NessieCircuits/Riotee_KicadLibrary/README.md

# KiCad Parts library for Riotee Hardware

This repository contains schematic symbols and footprints for the parts on the Riotee board, Riotee probe and the Riotee shields.

Since quite some of the parts are shared betwen the designs, we keep them in this central repository which is integrated as submodule in the other repositories.
