NessieCircuits/Riotee_KicadLibrary/(commit log)

2023-01-14 optimize sensor stencil openings
2023-01-15 add flexypin footprints
2023-02-16 add TS5A3166 and TLV71320 devices
2023-02-24 colored model of TE_1825058-1 dip switch
2023-02-24 color pin headers and 8-position DIP switch
2023-04-10 fix VM1010 footprint
2023-04-10 fix USB connector 3D model placement
2023-04-10 add solder bridge footprint
2023-04-12 update riotee module pin names
2023-04-13 refine assembly drawings of SHTC3 and VM1010
2023-04-13 add marker for negative pin of supercaps
2023-04-14 fix footprint SMD/THT property
2023-04-14 improve KXOB25 assembly drawing
2023-04-28 migrate symbol library to kicad 7
2023-04-28 migrate some footprints to kicad 7
2023-04-28 add sot23 footprint for diodes pmos
2023-04-28 add kikit tab footprint
2023-05-06 set footprint type of USB-C connector to unspecified
2024-06-26 update to kicad 8
2025-12-01 add module footprints
